fgrandel/hetida4office/README.md

# hetida4office
Office Automation Framework
### Sensor1 Dashboard
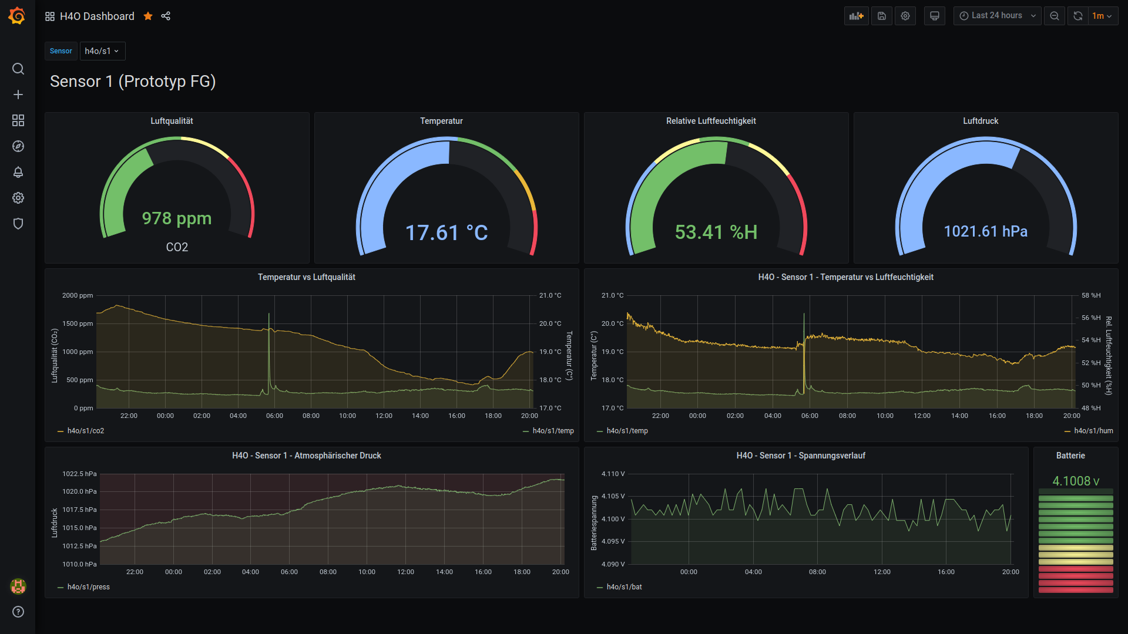
[picture p1: doc/h4oDashboard.PNG]
