fgrandel/hetida4office/edge/co2sensor/hardware/fab/1551V3-small/assembly/BOM.csv

ID | Name | Designator | Footprint | Quantity | Manufacturer Part | Manufacturer | Supplier | Supplier Part | Price | JLCPCB SMD
1 | 10uF | C1,C2 | C0603 | 2 | CL10A106KP8NNNC | SAMSUNG | LCSC | C19702 | 0.0125 | Yes
2 | 4.7uF | C3 | C0402 | 1 | CL05A475MP5NRNC | SAMSUNG | LCSC | C23733 | 0.0095 | Yes
3 | 22pF | C4,C5 | C0402 | 2 | 0402CG220J500NT | FH | LCSC | C1555 | 0.002 | Yes
4 | SS14 | D1 | SMA_L4.4-W2.8-LS5.4-RD | 1 | SS14 | MDD | LCSC | C2480 | 0.0187 | Yes
5 | FTSH-105-01-L-DV-K | J1 | FTSH-105-01-L-DV-K | 1 | FTSH-105-01-L-DV-K |  | Digi-Key | SAM8799-ND
6 | BM05B-SRSS-TB(LF)(SN) | J2,J4 | CONN-SMD-5P-P1.00_BM05B-SRSS-TB(LF)(SN) | 2 | BM05B-SRSS-TB(LF)(SN) | JST Sales America | LCSC | C160391 | 0.2627
7 | B2B-PH-K-S(LF)(SN) | J3 | CONN-TH_B2B-PH-K-S | 1 | B2B-PH-K-S(LF)(SN) | JST | LCSC | C131337 | 0.0322
8 | 10uH | L1 | IND-SMD_L6.0-W6.0_SLF6028T | 1 | SLF6028T-100M1R3-PF | TDK | LCSC | C138483 | 0.4328 | Yes
9 | KT-0603R | LED1,LED2,LED3 | LED0603-R-RD | 3 | KT-0603R | KENTO | LCSC | C2286 | 0.0059 | Yes
10 | AO3401A | Q1,Q2 | SOT-23_L2.9-W1.3-P0.95-LS2.4-BR | 2 | AO3401A | AOS | LCSC | C15127 | 0.1864 | Yes
11 | 22 | R1,R2 | R0402 | 2 | 0402WGF220JTCE | UniOhm | LCSC | C25092 | 0.0009 | Yes
12 | 1K | R3 | R0402 | 1 | 0402WGF4700TCE | UniOhm | LCSC | C25117 | 0.0008 | Yes
13 | 4.7K | R4 | R0402 | 1 | 0402WGF4701TCE | UniOhm | LCSC | C25900 | 0.0008 | Yes
14 | 100K | R5,R6,R7,R8 | R0402 | 4 | 0402WGF1003TCE | UniOhm | LCSC | C25741 | 0.0008 | Yes
15 | 330 | R9,R10 | R0402 | 2 | 0402WGF3300TCE | UniOhm | LCSC | C25104 | 0.0008 | Yes
16 | TS-1010-B-A | SW1,SW2 | KEY-SMD_TX-1010-X-X | 2 | TS-1010-B-A | XKB Enterprise | LCSC | C318941 | 0.0417
17 | MCP73831T-2ACI/OT | U1 | SOT-23-5_L3.0-W1.7-P0.95-LS2.8-BR | 1 | MCP73831T-2ACI/OT | Microchip Tech | LCSC | C424093 | 1.1469 | Yes
18 | TPS62203DBVR | U2 | SOT-23-5_L3.0-W1.7-P0.95-LS2.8-BR | 1 | TPS62203DBVR | TI | LCSC | C9051 | 0.8656 | Yes
19 | E73-2G4M08S1C | U3 | WIRELM-SMD_E73-2G4M08S1C | 1 | E73-2G4M08S1C | Chengdu Ebyte Elec Tech | LCSC | C356849 | 8.6161
20 | EKMB | U4 |  | 1
21 | 105017-0001 | USB1 | MICRO-USB-SMD_105017-0001 | 1 | 105017-0001 | MOLEX | LCSC | C136000 | 0.288
22 | 32.768KHz | X1 | FC-135R_L3.2-W1.5 | 1 | Q13FC1350000400 | EPSON | LCSC | C32346 | 0.5446 | Yes
