fgrandel/hetida4office/edge/co2sensor/hardware/fab/1591XXL-large/assembly/BOM.csv

ID | Name | Designator | Footprint | Quantity | Manufacturer Part | Manufacturer | Supplier | Supplier Part | Price | JLCPCB SMD
1 | SenseAir-LP8 | A1 | LP8 | 1
2 | 10uF | C1,C2 | C0603 | 2 | CL10A106KP8NNNC | SAMSUNG | LCSC | C19702 | 0.0125 | Yes
3 | 4.7uF | C3 | C0402 | 1 | CL05A475MP5NRNC | SAMSUNG | LCSC | C23733 | 0.0095 | Yes
4 | 22pF | C4,C5 | C0402 | 2 | 0402CG220J500NT | FH | LCSC | C1555 | 0.002 | Yes
5 | 470pF | C6 | C0402 | 1 | 0402B471K500NT | FH | LCSC | C1537 | 0.0019 | Yes
6 | 470m | C7 | AVX_SCM_L14.00_W6.30 | 1
7 | 10nF | C8 | C0402 | 1 | CL05B103KB5NNNC | SAMSUNG | LCSC | C15195 | 0.0013 | Yes
8 | 100nF | C9 | C0402 | 1 | CL05B104KO5NNNC | SAMSUNG | LCSC | C1525 | 0.0016 | Yes
9 | SS14 | D1 | SMA_L4.4-W2.8-LS5.4-RD | 1 | SS14 | MDD | LCSC | C2480 | 0.0187 | Yes
10 | FTSH-105-01-L-DV-K | J1 | FTSH-105-01-L-DV-K | 1 | FTSH-105-01-L-DV-K |  | Digi-Key | SAM8799-ND
11 | BM05B-SRSS-TB(LF)(SN) | J2,J4 | CONN-SMD-5P-P1.00_BM05B-SRSS-TB(LF)(SN) | 2 | BM05B-SRSS-TB(LF)(SN) | JST Sales America | LCSC | C160391 | 0.2627
12 | B2B-PH-K-S(LF)(SN) | J3 | CONN-TH_B2B-PH-K-S | 1 | B2B-PH-K-S(LF)(SN) | JST | LCSC | C131337 | 0.0322
13 | 10uH | L1 | IND-SMD_L6.0-W6.0_SLF6028T | 1 | SLF6028T-100M1R3-PF | TDK | LCSC | C138483 | 0.4328 | Yes
14 | KT-0603R | LED1,LED2,LED3 | LED0603-R-RD | 3 | KT-0603R | KENTO | LCSC | C2286 | 0.0059 | Yes
15 | AO3401A | Q1,Q2,Q3,Q4,Q5 | SOT-23_L2.9-W1.3-P0.95-LS2.4-BR | 5 | AO3401A | AOS | LCSC | C15127 | 0.1864 | Yes
16 | 22 | R1,R2 | R0402 | 2 | 0402WGF220JTCE | UniOhm | LCSC | C25092 | 0.0009 | Yes
17 | 1K | R3 | R0402 | 1 | 0402WGF4700TCE | UniOhm | LCSC | C25117 | 0.0008 | Yes
18 | 4.7K | R4 | R0402 | 1 | 0402WGF4701TCE | UniOhm | LCSC | C25900 | 0.0008 | Yes
19 | 100K | R5,R6,R7,R8,R12,R13,R14,R16,R22 | R0402 | 9 | 0402WGF1003TCE | UniOhm | LCSC | C25741 | 0.0008 | Yes
20 | 330 | R9,R10 | R0402 | 2 | 0402WGF3300TCE | UniOhm | LCSC | C25104 | 0.0008 | Yes
21 | 1K | R11,R15,R18 | R0402 | 3 | 0402WGF1001TCE | UniOhm | LCSC | C11702 | 0.0008 | Yes
22 | 500m | R17 | R0402 | 1 |  |  | Digi-Key
23 | 82k | R19 | R0402 | 1 |  |  | Digi-Key
24 | 910k | R20 | R0402 | 1 |  |  | Digi-Key
25 | 249k | R21 | R0402 | 1 |  |  | Digi-Key
26 | TS-1010-B-A | SW1,SW2 | KEY-SMD_TX-1010-X-X | 2 | TS-1010-B-A | XKB Enterprise | LCSC | C318941 | 0.0417
27 | MCP73831T-2ACI/OT | U1 | SOT-23-5_L3.0-W1.7-P0.95-LS2.8-BR | 1 | MCP73831T-2ACI/OT | Microchip Tech | LCSC | C424093 | 1.1469 | Yes
28 | TPS62203DBVR | U2 | SOT-23-5_L3.0-W1.7-P0.95-LS2.8-BR | 1 | TPS62203DBVR | TI | LCSC | C9051 | 0.8656 | Yes
29 | E73-2G4M08S1C | U3 | WIRELM-SMD_E73-2G4M08S1C | 1 | E73-2G4M08S1C | Chengdu Ebyte Elec Tech | LCSC | C356849 | 8.6161
30 | TPS22917DBVR | U4,U5 | SC_SOT23-6 | 2 | TPS22917DBVR | Texas Instruments | Digi-Key | 296-50498-1-ND
31 | MCP6041T-EOT | U6 | MCP6041T-E&SLASH_OT | 1 |  |  | Digi-Key
32 | MAX6006/LT1634 | U7 | 21-0051H | 1 |  |  | Digi-Key
33 | EKMB | U8 |  | 1
34 | 105017-0001 | USB1 | MICRO-USB-SMD_105017-0001 | 1 | 105017-0001 | MOLEX | LCSC | C136000 | 0.288
35 | 32.768KHz | X1 | FC-135R_L3.2-W1.5 | 1 | Q13FC1350000400 | EPSON | LCSC | C32346 | 0.5446 | Yes
