fgrandel/hetida4office/edge/co2sensor/mechanics/1551XXMFL.FCStd

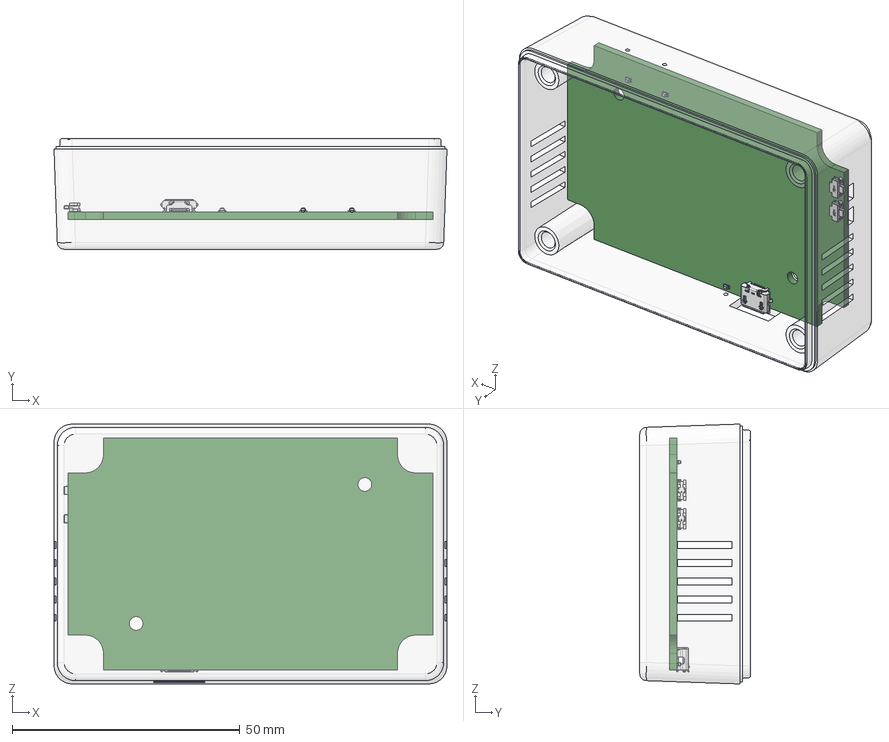
[picture p2: CAD file, 2021-07-04]
edge/co2sensor/mechanics/1551XXMFL.FCStd
86.2 x 24.2 x 57.0 mm
USB x 2
Switch1 x 2
Switch2 x 2
0603 Chip SMD LED (1.6x0.8mm) x 2
0603 Chip SMD LED (1.6x0.8mm)001 x 2
0603 Chip SMD LED (1.6x0.8mm)002 x 2
0603 Chip SMD LED (1.6x0.8mm)003 x 2
0603 Chip SMD LED (1.6x0.8mm)004 x 2
0603 Chip SMD LED (1.6x0.8mm)005 x 2
0603 Chip SMD LED (1.6x0.8mm)007 x 2
0603 Chip SMD LED (1.6x0.8mm)008 x 2
0603 Chip SMD LED (1.6x0.8mm)009 x 2
0603 Chip SMD LED (1.6x0.8mm)010 x 2
0603 Chip SMD LED (1.6x0.8mm)011 x 2
0603 Chip SMD LED (1.6x0.8mm)012 x 2
0603 Chip SMD LED (1.6x0.8mm)014 x 2
0603 Chip SMD LED (1.6x0.8mm)015 x 2
0603 Chip SMD LED (1.6x0.8mm)016 x 2
0603 Chip SMD LED (1.6x0.8mm)017 x 2
0603 Chip SMD LED (1.6x0.8mm)018 x 2
0603 Chip SMD LED (1.6x0.8mm)019 x 2
PCB x 2
Box with Openings
