fgrandel/hetida4office/edge/co2sensor/mechanics/1551V1.FCStd

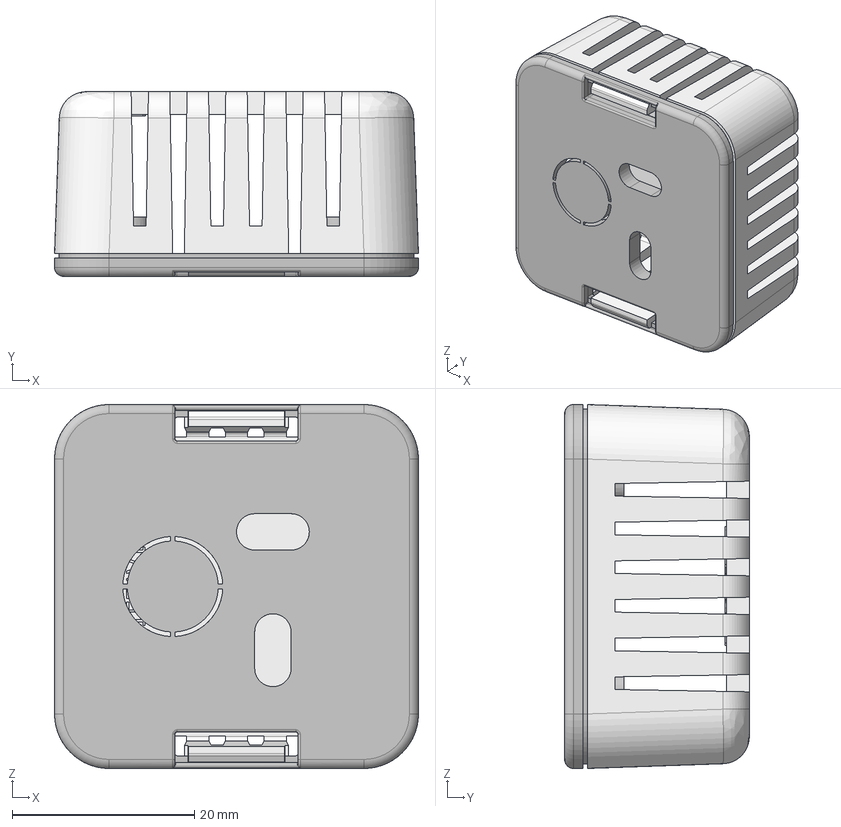
[picture p3: CAD file, 2021-07-04]
edge/co2sensor/mechanics/1551V1.FCStd
40.0 x 20.3 x 40.0 mm
1551V1 BASE
1551V1 COVER
