fgrandel/hetida4office/edge/co2sensor/mechanics/1551V3.FCStd

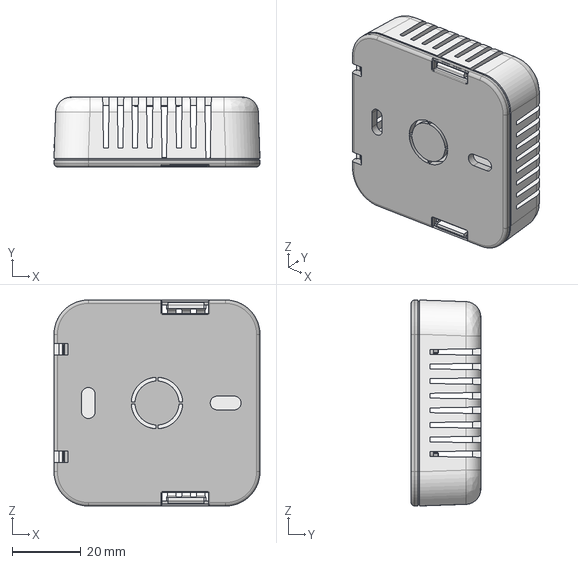
[picture p4: CAD file, 2021-07-04]
edge/co2sensor/mechanics/1551V3.FCStd
60.0 x 20.3 x 60.0 mm
1551V3 BASE
1551V3 COVER
