fgrandel/hetida4office/(list of files, cad)

Other CAD files:
edge/co2sensor/mechanics/1557BBK.FCStd
