fgrandel/hetida4office/(list of files, drawings)

Other design files:
edge/co2sensor/hardware/pcb-1551V3-small.json
edge/co2sensor/hardware/pcb-1591XXL.json
