fgrandel/hetida4office/(commit log)

2021-05-23 modularized hardware
    [BOM.csv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]
2021-07-04 use predefined constant for BME280 I2C address
2021-07-04 add more sensors and timeseries
2021-07-04 add CAD files for housing
    [1551V1.FCStd, 1551V3.FCStd, 1551XXMFL.FCStd, 1557BBK.FCStd]
2021-07-06 switch between board types via preprocessor constant
